AlexEnciu/PUMA_PCB/FootPrint_Symbols/CONMHF1-SMD-G-T.stp

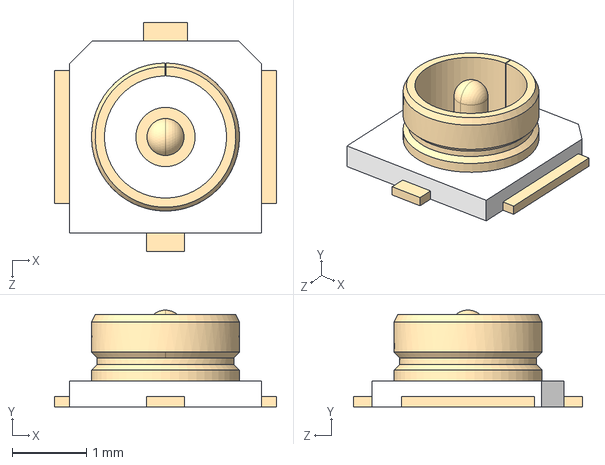
[picture p1: CAD file, 2024-11-03]
FootPrint_Symbols/CONMHF1-SMD-G-T.stp
3.00 x 1.31 x 3.10 mm
