AlexEnciu/PUMA_PCB/FootPrint_Symbols/CGA3EANP02A103J080AC.stp

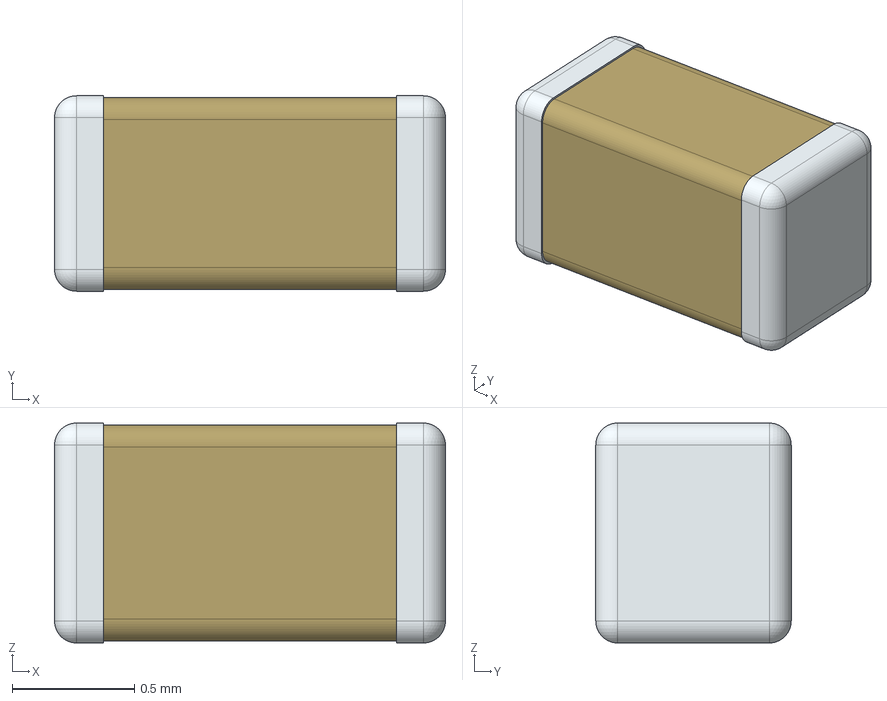
[picture p2: CAD file, 2024-08-14]
FootPrint_Symbols/CGA3EANP02A103J080AC.stp
1.60 x 0.8 x 0.9 mm
