AlexEnciu/PUMA_PCB/FootPrint_Symbols/C0603X104K5RACAUTO.stp

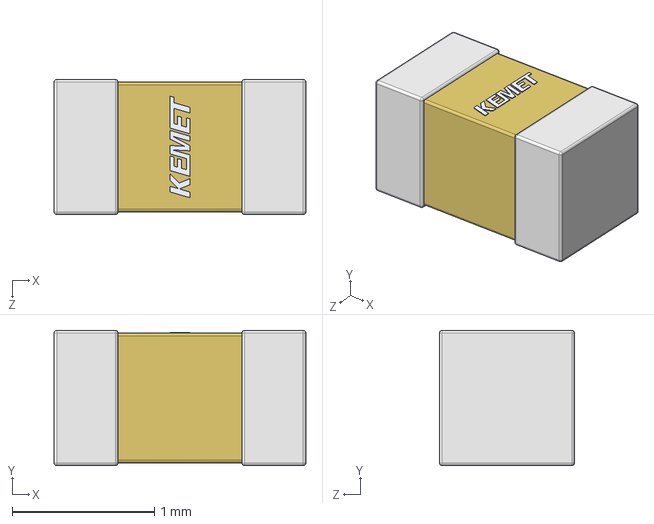
[picture p3: CAD file, 2024-08-13]
FootPrint_Symbols/C0603X104K5RACAUTO.stp
1.77 x 0.95 x 0.95 mm
