AlexEnciu/PUMA_PCB/FootPrint_Symbols/CONMHF4-SMD-G-T.stp

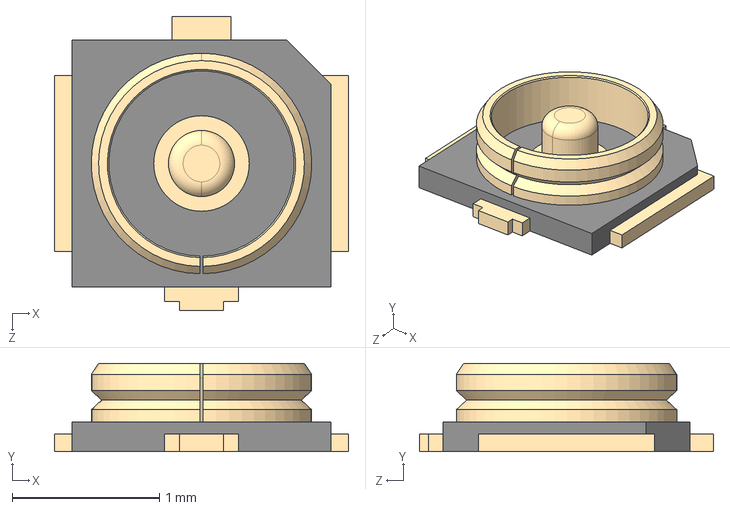
[picture p4: CAD file, 2024-08-13]
FootPrint_Symbols/CONMHF4-SMD-G-T.stp
2.00 x 0.6 x 2.00 mm
