AlexEnciu/PUMA_PCB/FootPrint_Symbols/SAMTEC-TMM-116-01-X-D-SM.step

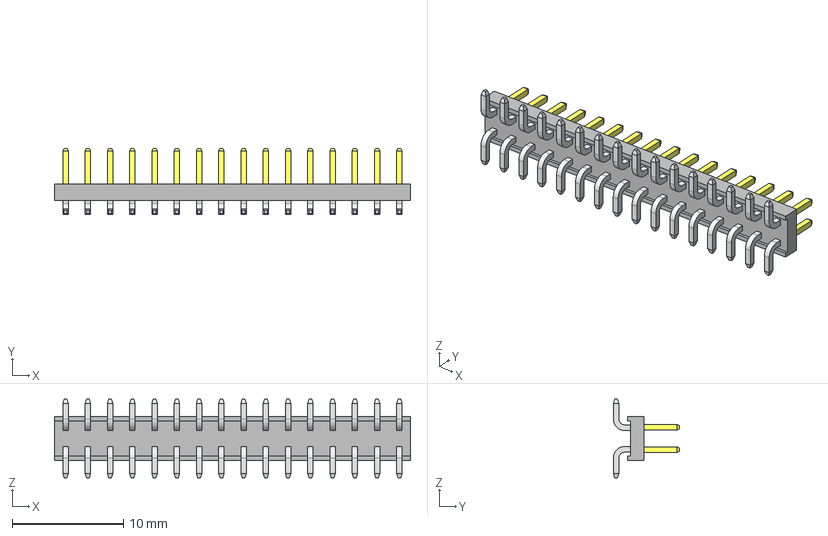
[picture p5: CAD file, 2024-05-16]
FootPrint_Symbols/SAMTEC-TMM-116-01-X-D-SM.step
32.0 x 5.97 x 7.06 mm
TMM-116-01-L-D-SM_body
TMM-116-01-L-D-SM_pins1
TMM-116-01-L-D-SM_sm_pins2
