AlexEnciu/PUMA_PCB/FootPrint_Symbols/MICROFC-30035-SMT-TR1.step

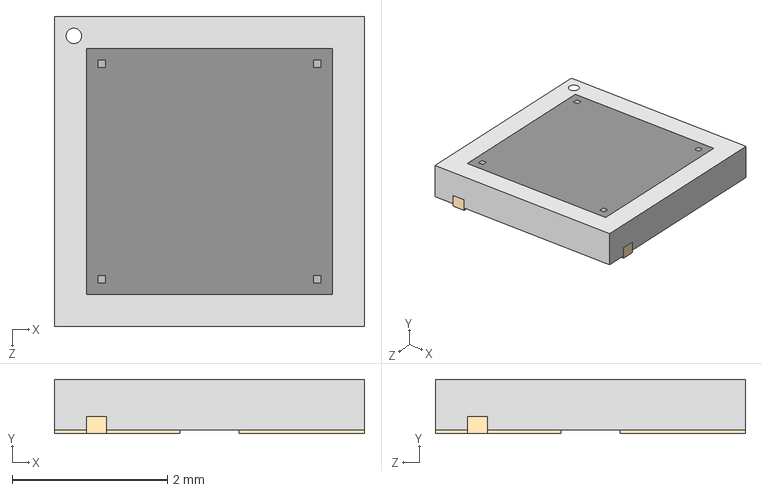
[picture p6: CAD file, 2024-05-16]
FootPrint_Symbols/MICROFC-30035-SMT-TR1.step
4.00 x 0.7 x 4.00 mm
