AlexEnciu/PUMA_PCB/FootPrint_Symbols/87832-0411.stp

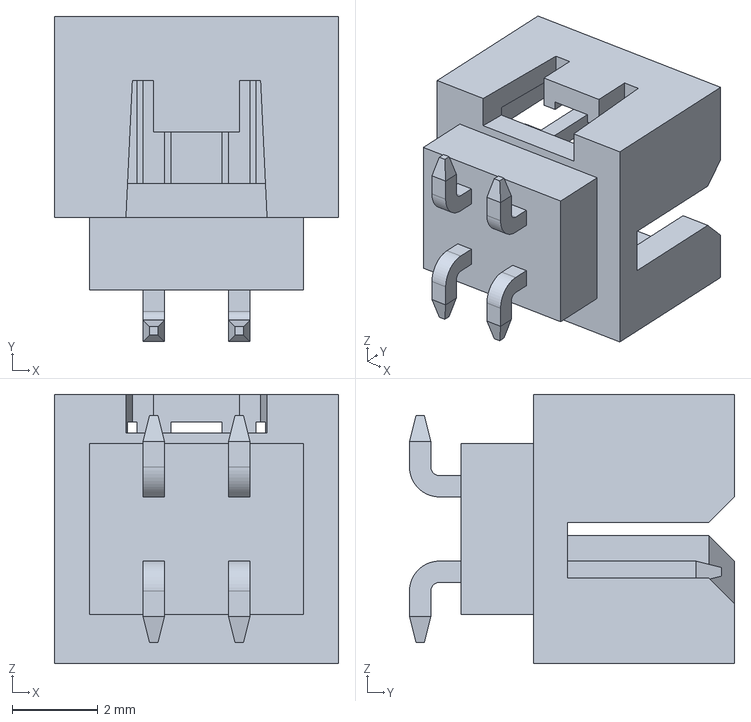
[picture p7: CAD file, 2024-08-12]
FootPrint_Symbols/87832-0411.stp
6.65 x 7.60 x 6.30 mm
