AlexEnciu/PUMA_PCB/FootPrint_Symbols/440055-3.stp

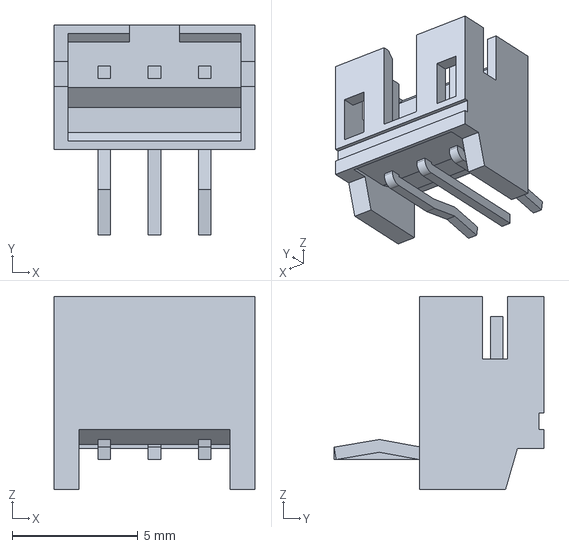
[picture p8: CAD file, 2024-08-05]
FootPrint_Symbols/440055-3.stp
8.00 x 8.35 x 7.70 mm
