AlexEnciu/PUMA_PCB/FootPrint_Symbols/1778764.stp

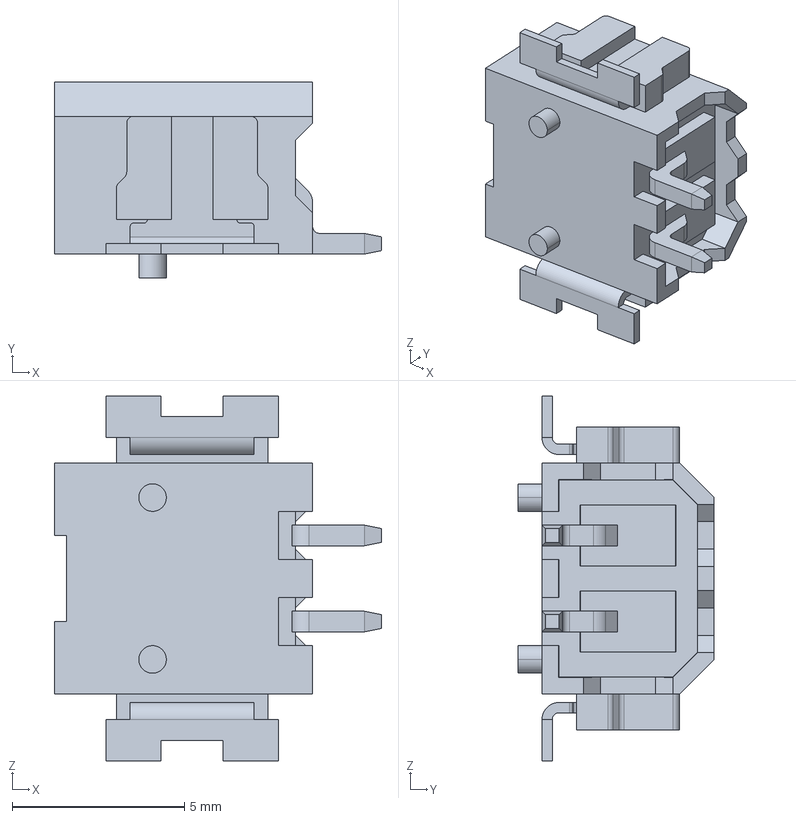
[picture p9: CAD file, 2024-06-21]
FootPrint_Symbols/1778764.stp
9.50 x 5.70 x 10.6 mm
