AlexEnciu/PUMA_PCB/(list of files, cad)

Other CAD files:
FootPrint_Symbols/MMJCG168CB7105KRPA18.stp
