AlexEnciu/PUMA_PCB/KiCAD/PUMA_PCB_REV2/PUMA_PCB_REV2-B_Cu.pdf

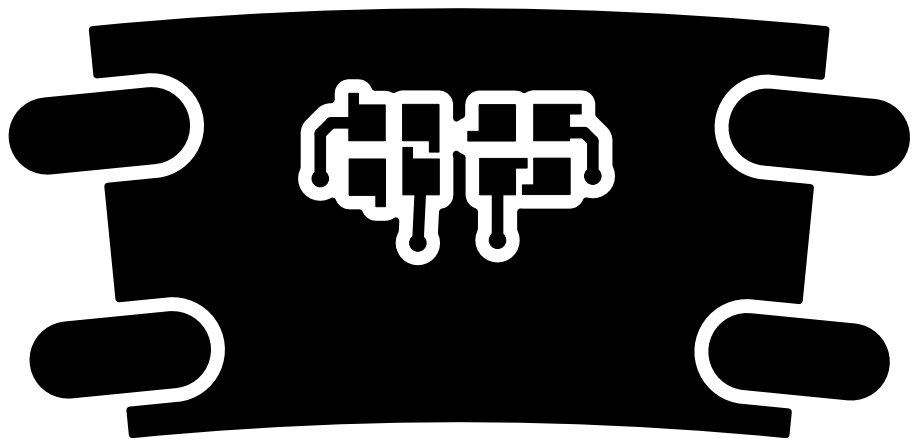
[picture p10: page 1]
