AlexEnciu/PUMA_PCB/KiCAD/PUMA_PCB_REV2/PUMA_PCB_REV2-B_Silkscreen.pdf

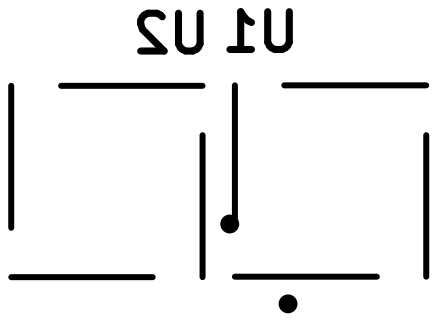
[picture p11: page 1]
