AlexEnciu/PUMA_PCB/KiCAD/PUMA_PCB_REV2/PUMA_PCB_REV2-F_Cu.pdf

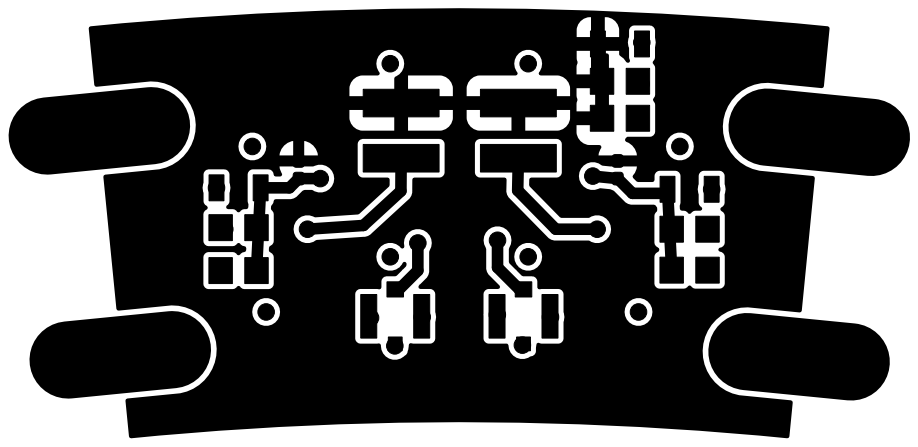
[picture p12: page 1]
