AlexEnciu/PUMA_PCB/KiCAD/PUMA_PCB_REV2/PUMA_PCB_REV2-F_Silkscreen.pdf

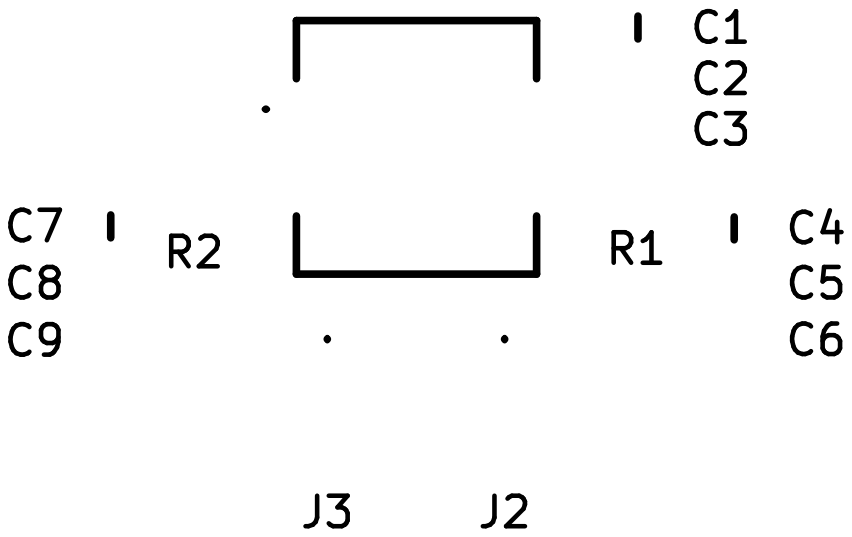
[picture p13: page 1]
