AlexEnciu/PUMA_PCB/KiCAD/PUMA_PCB_REV2/PUMA_PCB_REV2.pdf

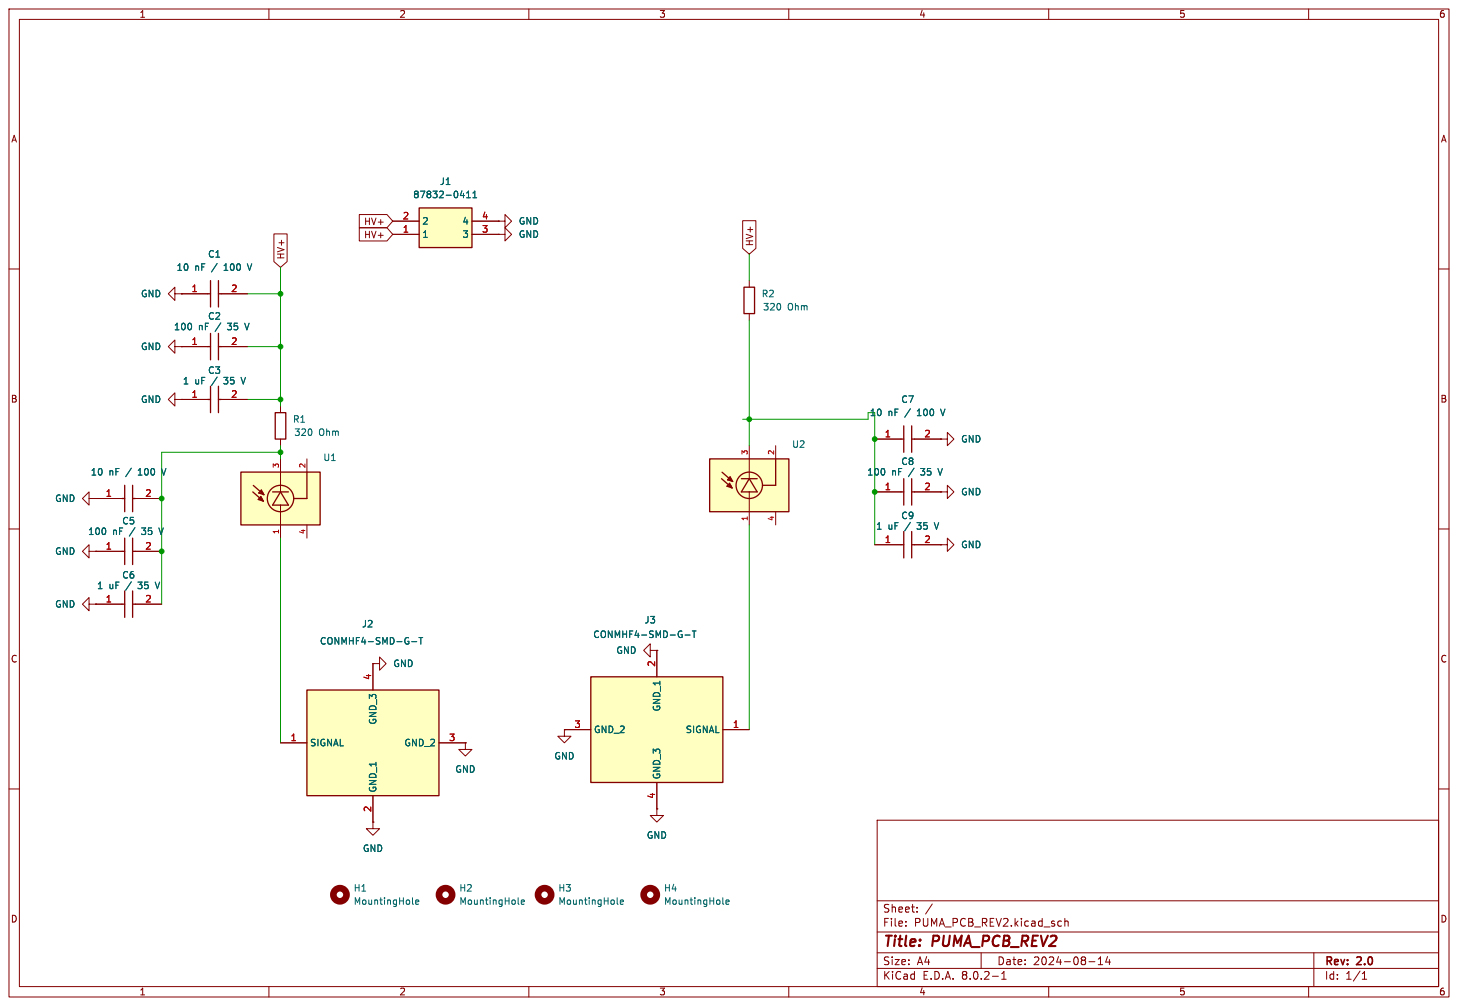
[picture p14: page 1]
