AlexEnciu/PUMA_PCB/(commit log)

2024-05-24 PCB edge shape + 2 SiPMs
    [PUMA_PCB_REV1.kicad_pcb, PUMA_PCB_REV1.kicad_sch]
2024-05-24 added all SiPM and matched to Samtec 32 pin connector according to scheme
    [PUMA_PCB_REV1.kicad_sch]
2024-05-24 aligned first 6 SiPms and components
    [PUMA_PCB_REV1.kicad_pcb]
2024-05-24 first attempt for routing between samtec connector and SiPMs
    [PUMA_PCB_REV1.kicad_pcb]
2024-05-27 traces and vias for first group of SiPMs
2024-05-27 tracing with impedence match 50 Ohm
    [PUMA_PCB_REV1.kicad_pcb]
2024-05-27 positioned capacitors and resistors and connected
    [PUMA_PCB_REV1.kicad_pcb]
2024-05-27 3D models included
    [PUMA_PCB_REV1.kicad_pcb]
2024-05-28 version 1.0 of PCB
    [PUMA_PCB_REV1.kicad_pcb]
2024-05-31 redid tracks and added GND to PADIWA and added mounting holes
2024-06-10 added grounding zone first attempt
    [PUMA_PCB_REV1.kicad_pcb, PUMA_PCB_REV1.kicad_sch]
2024-06-10 added grounding zone second attempt
    [PUMA_PCB_REV1.kicad_pcb]
2024-06-17 added first attempt for HV connection
    [PUMA_PCB_REV1.kicad_pcb, PUMA_PCB_REV1.kicad_sch]
2024-06-17 connect HV - problem in the center of board
2024-06-21 connect HV and added missing 3d models
    [1778764.stp, PUMA_PCB_REV1.kicad_pcb, PUMA_PCB_REV1.kicad_sch]
2024-08-05 created new folder for revision 2, which will be smaller PCBs for 2 SiPM each
    [PUMA_PCB_REV1.kicad_pcb, PUMA_PCB_REV2.kicad_pcb, PUMA_PCB_REV2.kicad_sch]
2024-08-05 edge outlines
    [PUMA_PCB_REV2.kicad_pcb]
2024-08-05 schematic placed
    [PUMA_PCB_REV1.kicad_pcb, PUMA_PCB_REV2.kicad_pcb, PUMA_PCB_REV2.kicad_sch]
2024-08-05 positioned and connected all components
    [PUMA_PCB_REV2.kicad_pcb, PUMA_PCB_REV2.kicad_sch]
2024-08-05 footprints and 3D models
    [440055-3.stp]
2024-08-07 changed connector to Molex 87832
    [PUMA_PCB_REV2.kicad_sch]
2024-08-12 old outline
    [87832-0411.stp]
2024-08-13 symmetric board iteration 1.0
    [C0603X104K5RACAUTO.stp, CONMHF4-SMD-G-T.stp, MMJCG168CB7105KRPA18_1uF.stp, PUMA_PCB_REV2.kicad_pcb, PUMA_PCB_REV2.kicad_sch]
2024-08-14 symmetric board iteration 1.1
    [CGA3EANP02A103J080AC.stp, MMJCG168CB7105KRPA18.stp, PUMA_PCB_REV2.kicad_pcb]
2024-08-14 changed capacitor C4 and C11 to 10nF
    [PUMA_PCB_REV2.kicad_pcb, PUMA_PCB_REV2.kicad_sch]
2024-08-14 changed schematic
    [PUMA_PCB_REV2.kicad_pcb, PUMA_PCB_REV2.kicad_sch]
2024-08-15 larger traces, repositioning of vias
    [PUMA_PCB_REV2-B_Cu.gbr, PUMA_PCB_REV2-B_Silkscreen.gbr, PUMA_PCB_REV2-Edge_Cuts.gbr, PUMA_PCB_REV2-F_Cu.gbr, PUMA_PCB_REV2-F_Silkscreen.gbr, PUMA_PCB_REV2-In1_Cu.gbr, PUMA_PCB_REV2-In2_Cu.gbr, PUMA_PCB_REV2-job.gbrjob]
2024-08-20 repositioned capacitors on the MPPC side
    [PUMA_PCB_REV2-B_Cu.gbr, PUMA_PCB_REV2-B_Silkscreen.gbr, PUMA_PCB_REV2-Edge_Cuts.gbr, PUMA_PCB_REV2-F_Cu.gbr, PUMA_PCB_REV2-F_Silkscreen.gbr, PUMA_PCB_REV2-In1_Cu.gbr, PUMA_PCB_REV2-In2_Cu.gbr, PUMA_PCB_REV2-job.gbrjob]
2024-08-21 put the HV filters closer to the HV
    [PUMA_PCB_REV2.kicad_pcb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]
2024-09-17 changed holes
2024-09-25 changed mhf4 to mhf1
    [PUMA_PCB_REV2-B_Cu.gbr, PUMA_PCB_REV2-B_Silkscreen.gbr, PUMA_PCB_REV2-Edge_Cuts.gbr, PUMA_PCB_REV2-F_Cu.gbr, PUMA_PCB_REV2-F_Silkscreen.gbr, PUMA_PCB_REV2-In1_Cu.gbr, PUMA_PCB_REV2-In2_Cu.gbr, PUMA_PCB_REV2-job.gbrjob]
2024-10-14 implemented new comments. This is Rev. 3.
    [PUMA_PCB_REV2-B_Cu.gbr, PUMA_PCB_REV2-B_Silkscreen.gbr, PUMA_PCB_REV2-Edge_Cuts.gbr, PUMA_PCB_REV2-F_Cu.gbr, PUMA_PCB_REV2-F_Silkscreen.gbr, PUMA_PCB_REV2-In1_Cu.gbr, PUMA_PCB_REV2-In2_Cu.gbr, PUMA_PCB_REV2-job.gbrjob]
2024-10-14 small changes
    [PUMA_PCB_REV2.kicad_pcb]
2024-11-03 new rev 3, since one of the mounting holes was broken
    [CONMHF1-SMD-G-T.stp, PUMA_PCB_REV2.kicad_sch, PUMA_PCB_REV3.kicad_pcb, PUMA_PCB_REV3.kicad_sch]
2024-11-04 changed hole size, added 2 more HV+ vias, changed font size
    [PUMA_PCB_REV2.kicad_pcb, PUMA_PCB_REV3.kicad_pcb]
2024-11-25 changed pad shape of SiPMs
    [PUMA_PCB_REV3.kicad_pcb]
