AlexEnciu/PUMA_PCB/(notices)

Notices in the files:
FootPrint_Symbols/SAMTEC-TMM-116-01-X-D-SM.step:
author */ ('License CC BY-ND 4.0'),
